Ocampo2004/Estacion_Meteorologica/Arquitectura_Sistema_Version1.pdf

# Arquitectura del Sistema

# Estación Meteorológica Portátil

### Universidad Nacional de Colombia

2026

## Índice

1. Arquitectura del Sistema | 2

## 1. Arquitectura del Sistema

### 1.1. Árbol de Potencia

El sistema de alimentación se basa en una batería recargable de ion de litio de 3.7

V. A partir de esta fuente, se implementan convertidores DC-DC tipo boost y buck para

generar los niveles de tensión requeridos por los diferentes módulos del sistema.

Cada bloque del árbol de potencia incluye su respectivo voltaje, corriente y potencia

estimada, lo cual permite evaluar el consumo total del sistema y verificar el cumplimiento

del requerimiento de autonomía.

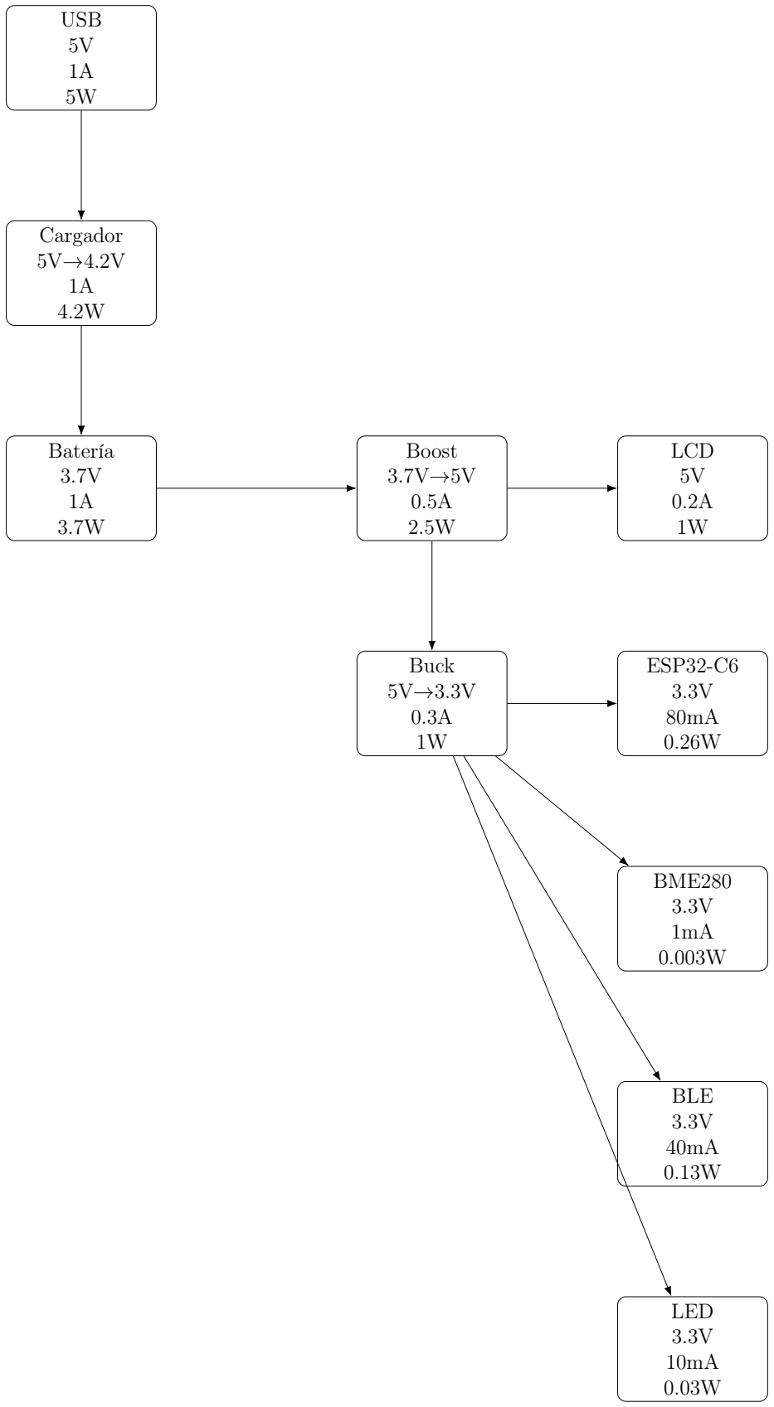
[picture p9: figure]
USB 5V 1A 5W; Cargador 5V→4.2V 1A 4.2W; Batería 3.7V 1A 3.7W; Boost 3.7V→5V 0.5A 2.5W; LCD 5V 0.2A 1W; Buck 5V→3.3V 0.3A 1W; ESP32-C6 3.3V 80mA 0.26W; BME280 3.3V 1mA 0.003W; BLE 3.3V 40mA 0.13W; LED 3.3V 10mA 0.03W

Figura 1: Árbol de potencia con parámetros eléctricos

Este análisis permite estimar un consumo total aproximado inferior a 1.5 W en ope-

ración normal, lo cual es consistente con el requerimiento de autonomía del sistema.

### 1.2. Arquitectura de Hardware

La arquitectura de hardware del sistema se basa en una organización modular que

permite la integración eficiente de los distintos subsistemas.

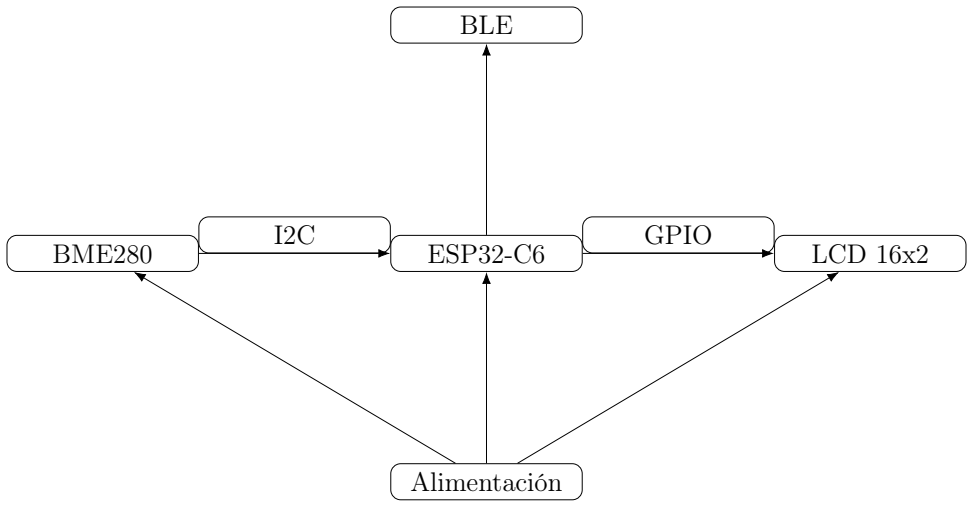
[picture p10: figure]
BME280; ESP32-C6; LCD 16x2; Alimentación; BLE; GPIO

Figura 2: Arquitectura de hardware del sistema

El microcontrolador ESP32-C6 actúa como núcleo del sistema, gestionando la ad-

quisición de datos desde el sensor BME280 mediante comunicación I2C. La información

procesada es enviada a una pantalla LCD para su visualización en tiempo real.

El sistema de alimentación suministra energía regulada a todos los módulos, mientras

que la comunicación inalámbrica se realiza mediante BLE integrado en el microcontrola-

dor.

### 1.3. Arquitectura de Firmware

El firmware se organiza en módulos funcionales que permiten una implementación

estructurada, facilitando el mantenimiento y la escalabilidad.

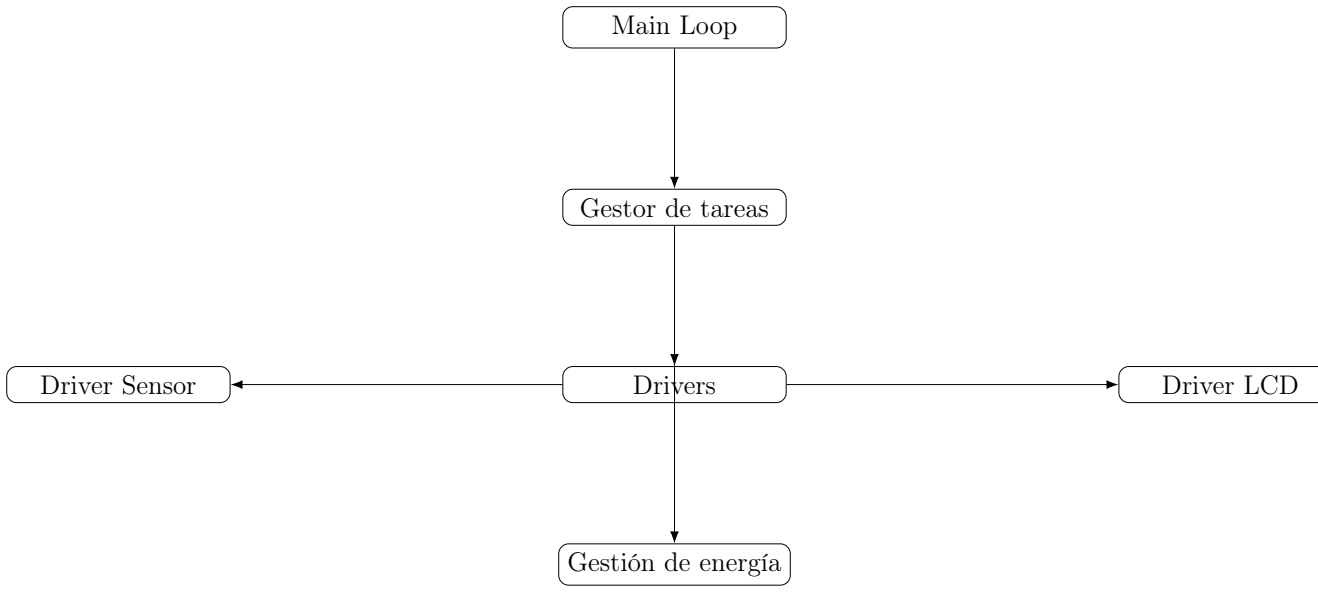
[picture p11: figure]
Main Loop; Gestor de tareas; Driver Sensor; Drivers; Driver LCD; Gestión de energía

Figura 3: Arquitectura del firmware

El sistema opera mediante un ciclo principal que ejecuta tareas periódicas, incluyendo

adquisición de sensores, procesamiento de datos y actualización de la interfaz de usuario.

### 1.4. Diagrama de Flujo

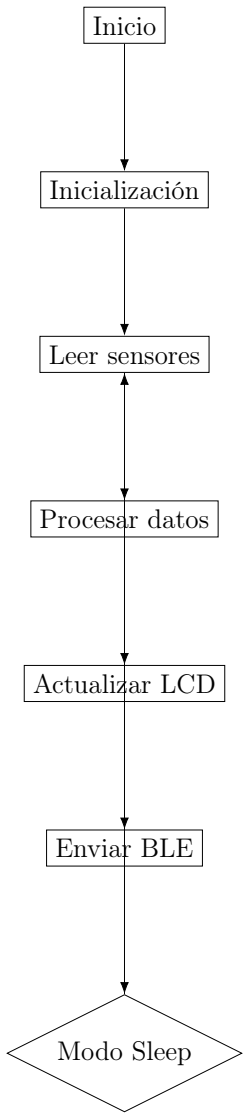
[picture p12: figure]
Inicio; Inicialización; Leer sensores; Procesar datos; Actualizar LCD; Enviar BLE; Modo Sleep

Figura 4: Diagrama de flujo del firmware

### 1.5. Arquitectura de Software

El sistema sigue un modelo por capas que separa la lógica de aplicación del hardware

físico.

Capa de Aplicación

HAL / Drivers

Hardware

Comunicación BLE

Figura 5: Arquitectura de software

Este enfoque permite modularidad, reutilización de código y facilidad de manteni-

miento.
