Ocampo2004/Estacion_Meteorologica/PCB_ALTIUM.PDF

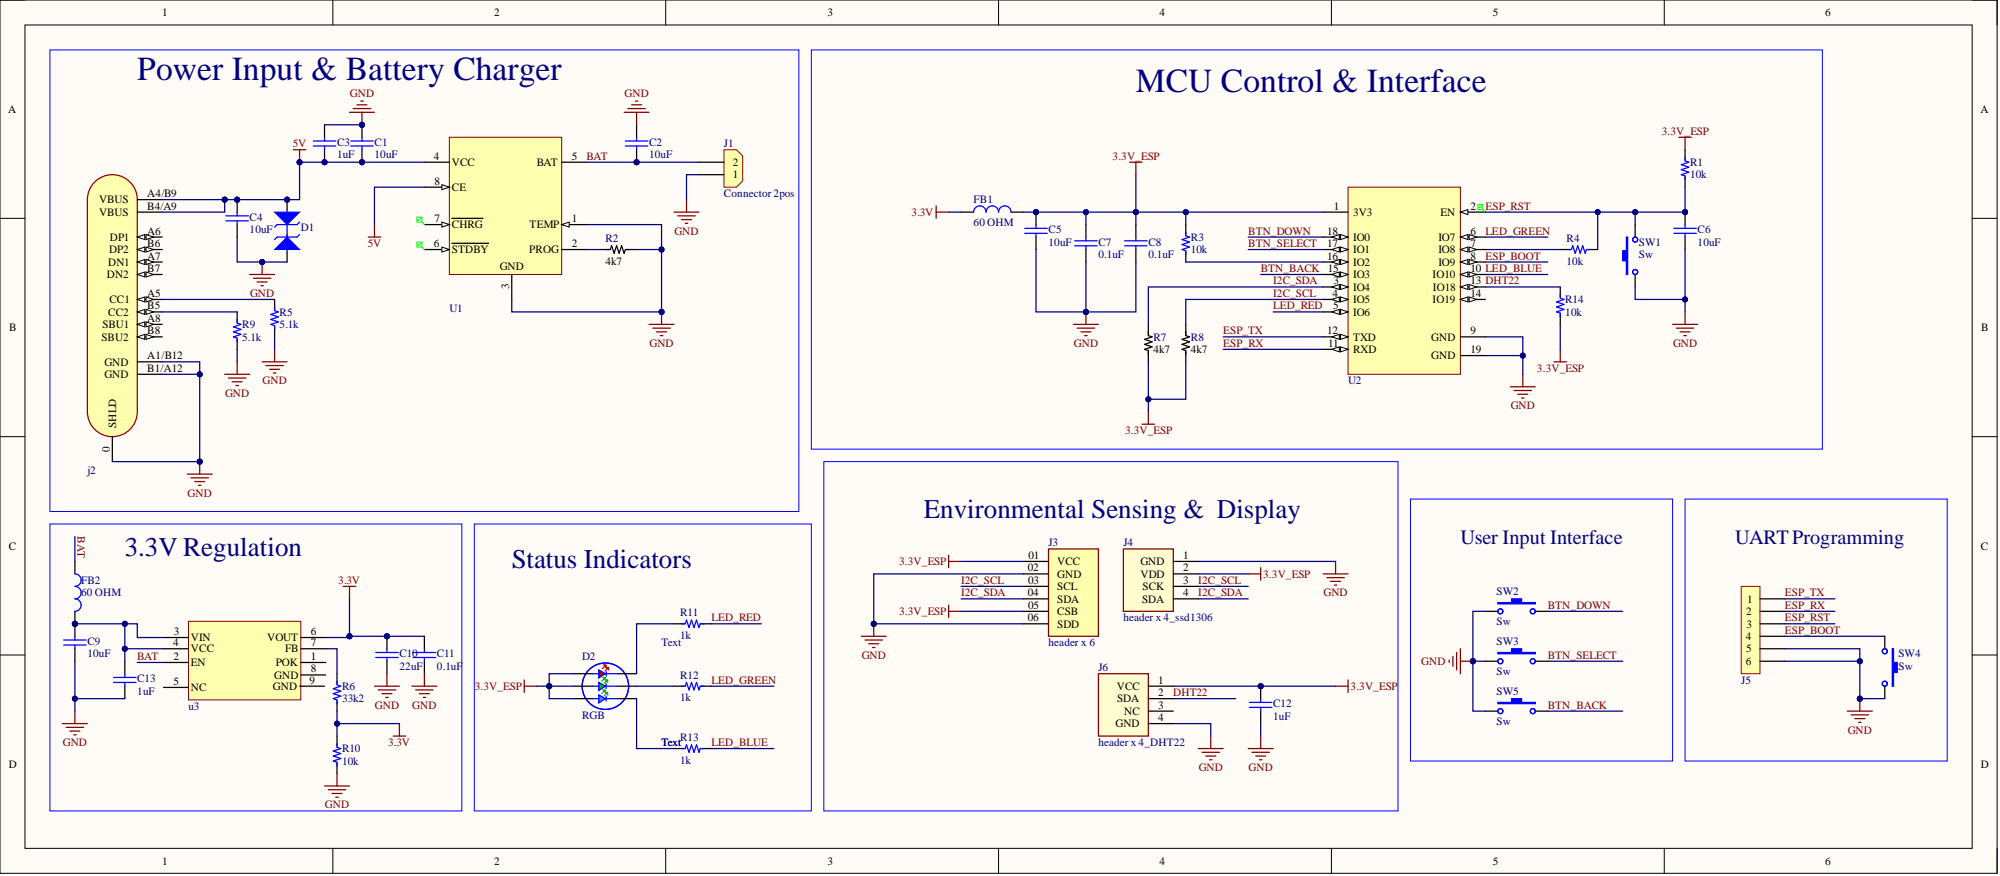
[picture p14: page 1]

Power Input & Battery Charger

I2C_SCL | 4 | 1 4
L E D _ RE D

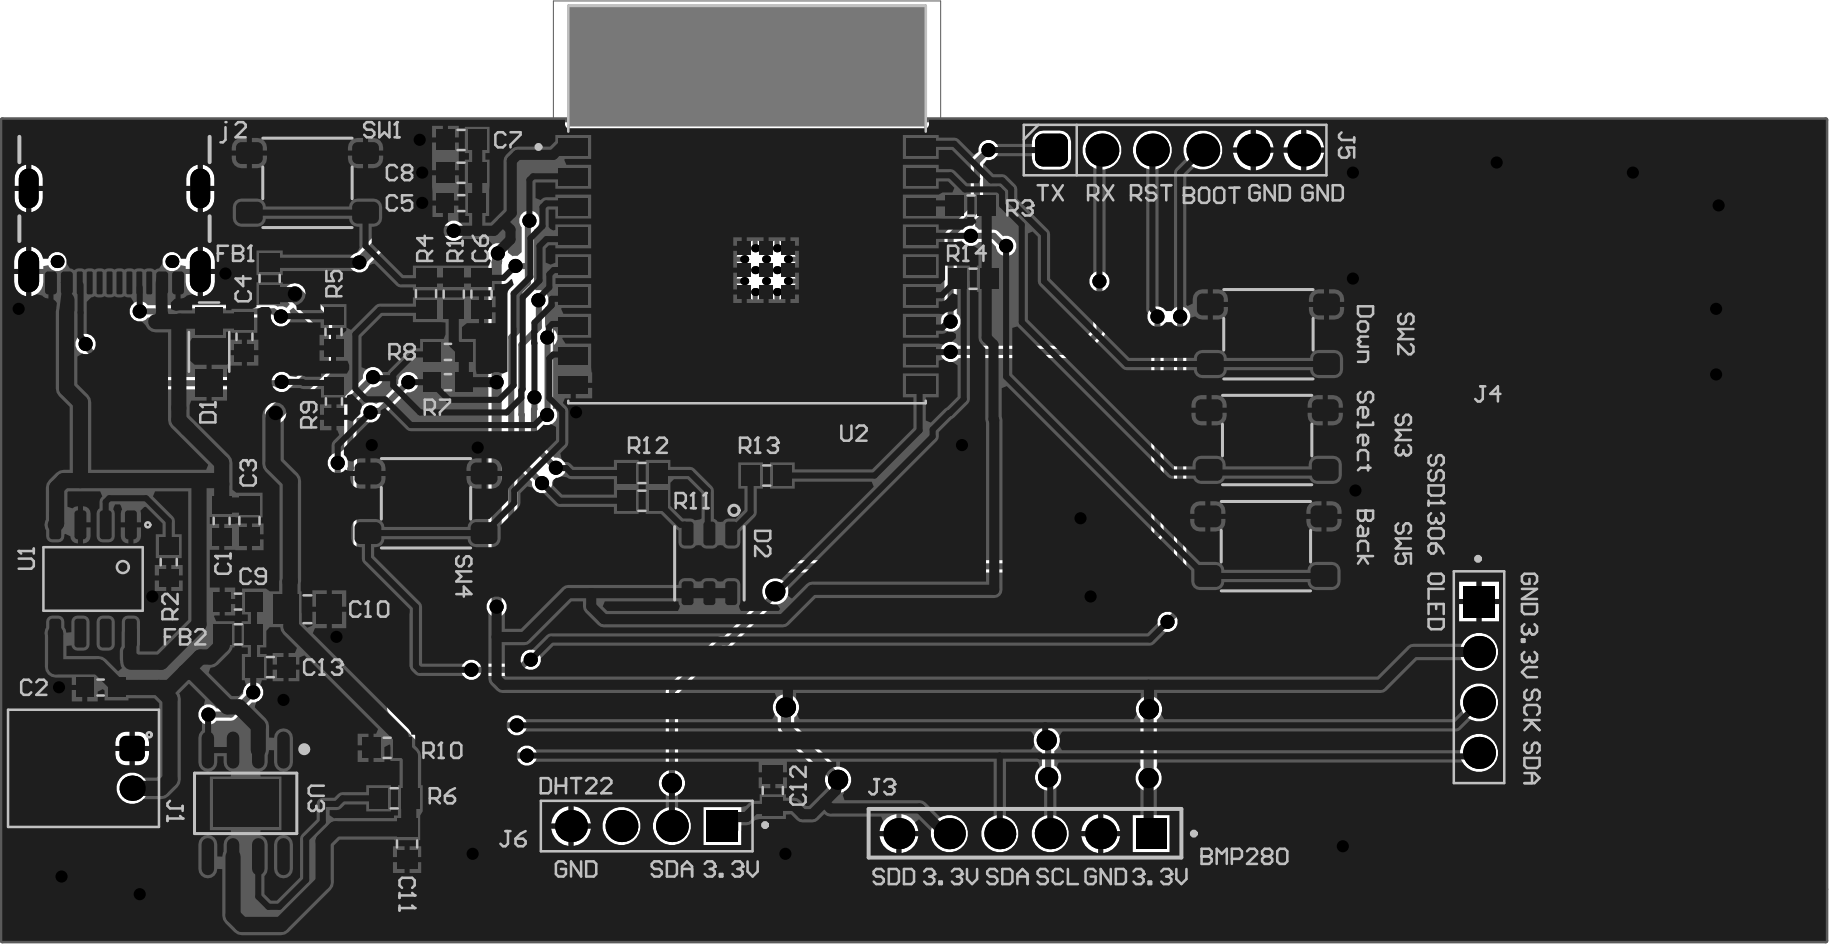
[picture p15: page 2]

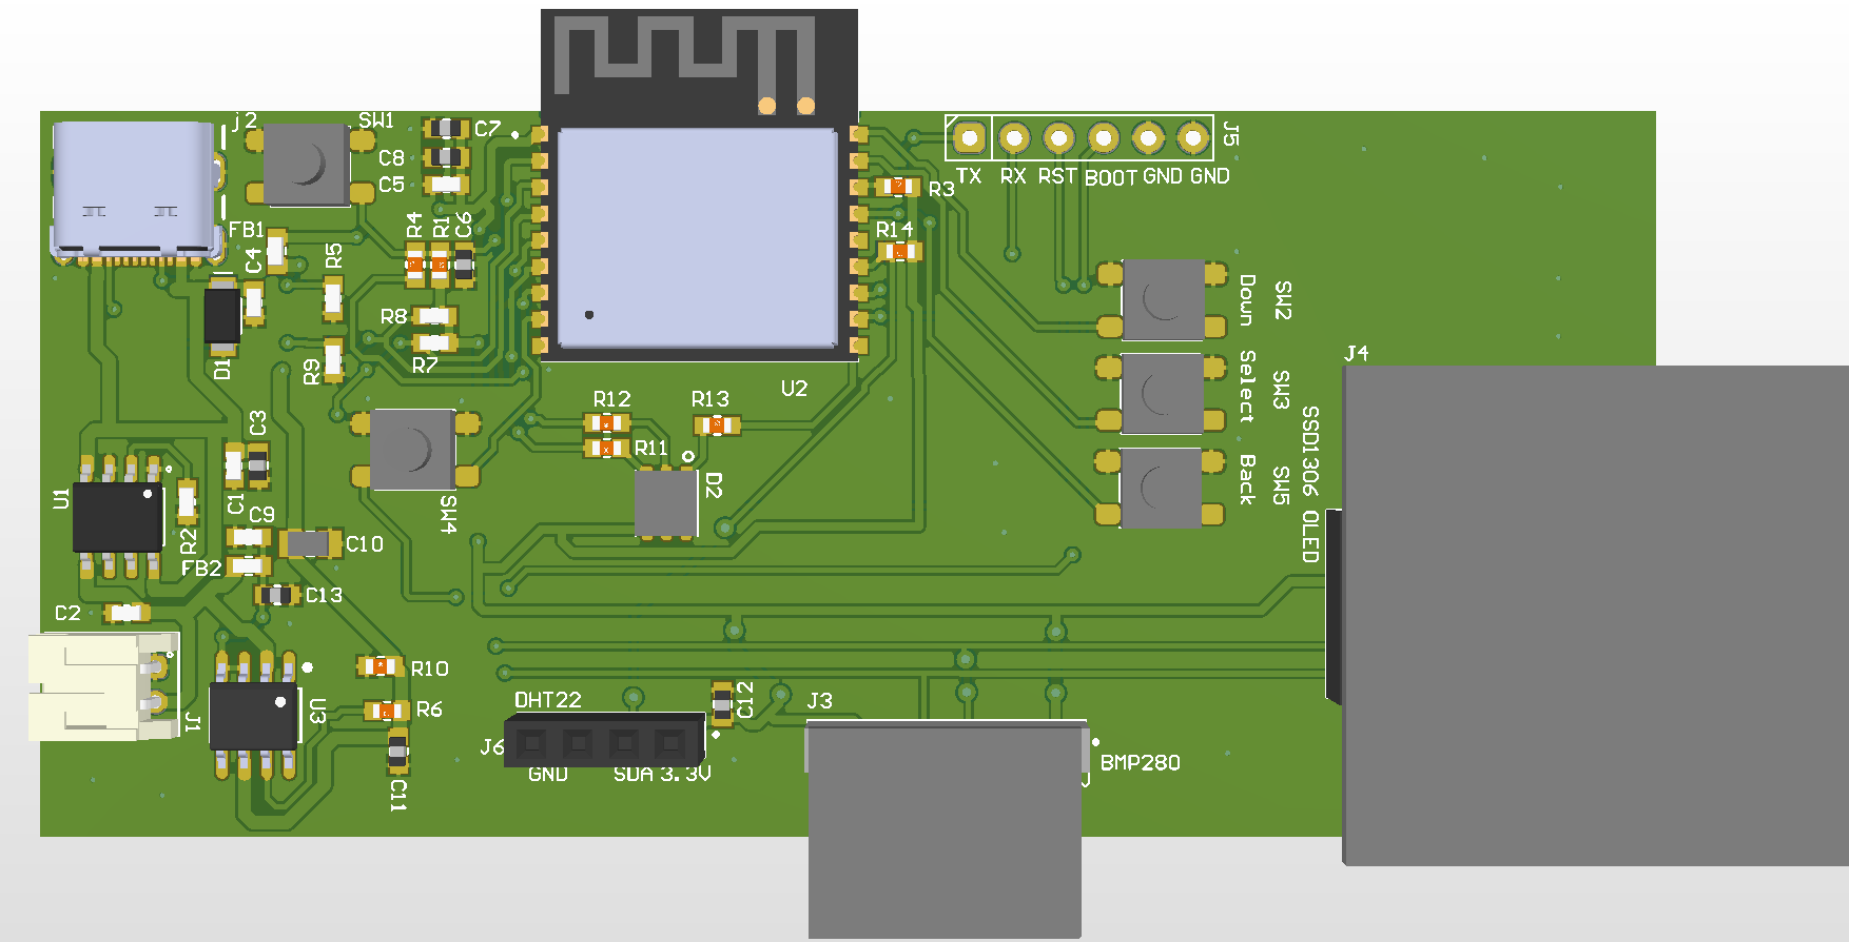
[picture p16: page 3]
