Ocampo2004/Estacion_Meteorologica/(commit log)

2026-06-18 Se agrega prueba de concepto
2026-06-18 Se agrega Presentacion, Esquematicos, Diseño PCB y Nota_Aplicacion
